ElectronicCats/flipper-addons/FLIPPER_CANBUS/CANBUS_Flipper.kicad_pcb

## KiCad design FLIPPER_CANBUS/CANBUS_Flipper.kicad_pcb (2025-12-16)

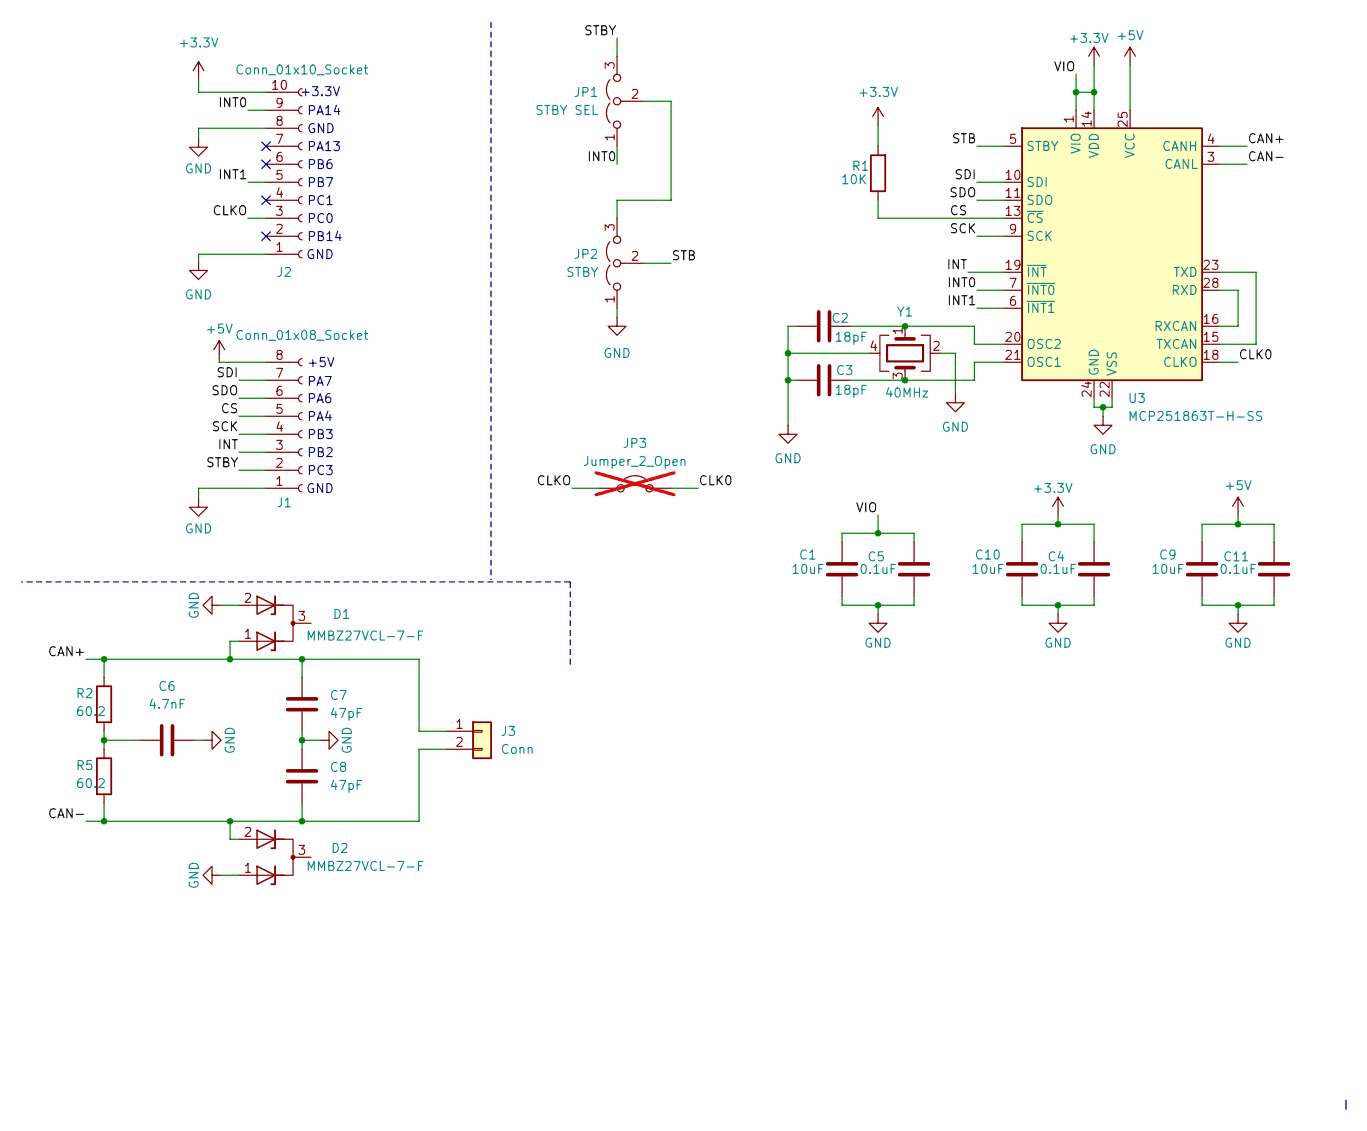
[picture p3: schematic CANBUS_Flipper.kicad_sch]

Parts:
C1, C9, C10: 10uF; C_0603_1608Metric; LCSC# C19702
C2, C3: 18pF; C_0603_1608Metric; LCSC# C5137620
C4, C5, C11: 0.1uF; C_0603_1608Metric; LCSC# C14663
C6: 4.7nF; C_0603_1608Metric; LCSC# C85980
C7, C8: 47pF; C_0603_1608Metric; LCSC# C5137501
D1, D2: MMBZ27VCL-7-F; SOT-23; LCSC# C698227
J1: Conn_01x08_Socket; PinHeader_1x08_P2.54mm_Vertical; LCSC# C7501586
J2: Conn_01x10_Socket; PinHeader_1x10_P2.54mm_Vertical; LCSC# C7430366
J3: Conn; TerminalBlock_bornier-2_P5.08mm
JP1: STBY SEL; Jumper; LCSC# C163836
JP2: STBY; Jumper; LCSC# C163836
JP3: Jumper_2_Open; SolderJumper-2_P1.3mm_Open_Pad1.0x1.5mm; not fitted
R1: 10K; R_0603_1608Metric; LCSC# C217281
R2, R5: 60.2; R_0603_1608Metric; LCSC# C2086358
U3: MCP251863T-H-SS; SSOP-28_5.3x10.2mm_P0.65mm; LCSC# C5226885
Y1: 40MHz; Crystal_SMD_EuroQuartz_MT-4Pin_3.2x2.5mm; LCSC# C1985459

Connections:
+3.3V: C1.2, C4.2, C5.2, C10.2, J2.10, R1.2, U3.1 (VIO), U3.14 (VDD)
+5V: C9.2, C11.2, J1.8, U3.25 (VCC)
/CAN+: C7.2, D1.1 (K), J3.1, R2.1, U3.4 (CANH)
/CAN-: C8.1, D2.2 (K), J3.2, R5.2, U3.3 (CANL)
/CLK0: JP3.2 (B), U3.18 (CLKO); also elsewhere on the board
/CLKO: J2.3; also elsewhere on the board
/CS: J1.5, R1.1, U3.13 (~CS)
/INT: J1.3, U3.19 (~INT)
/INT0: J2.9, JP1.1 (A), U3.7 (~INT0)
/INT1: J2.5, U3.6 (~INT1)
/SCK: J1.4, U3.9 (SCK)
/SDI: J1.7, U3.10 (SDI)
/SDO: J1.6, U3.11 (SDO)
/STB: JP2.2 (C), U3.5 (STBY)
/STBY: J1.2, JP1.3 (B)
GND: C1.1, C2.1, C3.1, C4.1, C5.1, C6.2, C7.1, C8.2, C9.1, C10.1, C11.1, D1.2 (K), D2.1 (K), J1.1, J2.1, J2.8, JP2.1 (A), U3.22 (VSS), U3.24 (GND), Y1.2, Y1.4
unnamed: C6.1, R2.2, R5.1
unnamed: JP1.2 (C), JP2.3 (B)
unnamed: C3.2, U3.21 (OSC1), Y1.3
unnamed: C2.2, U3.20 (OSC2), Y1.1
unnamed: U3.16 (RXCAN), U3.28 (RXD)
unnamed: U3.15 (TXCAN), U3.23 (TXD)

Notes on the sheet:
PA6
GND
PB3
PC1
PA7
+3.3V
PA13
PB6
PB14
PC3
PB2
PA14
+5V
PA4
PB7
PC0

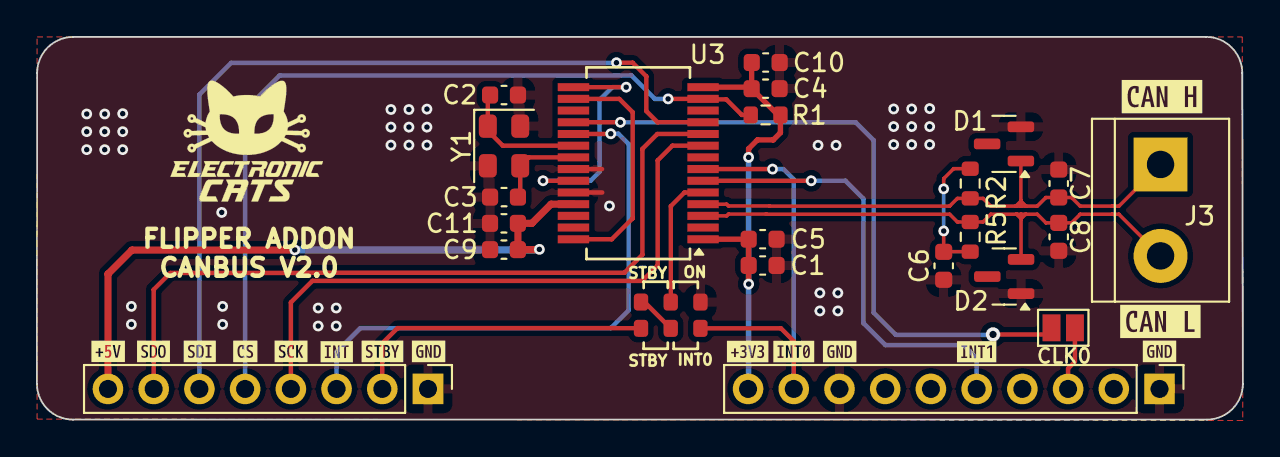
[picture p4: board CANBUS_Flipper.kicad_pcb from above]

Board: 2 copper layers, 67.0 x 21.3 mm, 39 parts (0 on the bottom side), 22 nets.

Other parts of the board:
CLK0: Jumper_2_Open; SolderJumper-2_P1.3mm_Open_Pad1.0x1.5mm
kibuzzard-65B92FFC: G***; kibuzzard-65B92FFC
kibuzzard-65B9300E: G***; kibuzzard-65B9300E
kibuzzard-6930B2A6: G***; kibuzzard-6930B2A6
kibuzzard-6930B2E0: G***; kibuzzard-6930B2E0
kibuzzard-6930B9E8: G***; kibuzzard-6930B9E8
kibuzzard-6930B93D: G***; kibuzzard-6930B93D
kibuzzard-6930B209: G***; kibuzzard-6930B209
kibuzzard-6930B295: G***; kibuzzard-6930B295
kibuzzard-6930B972: G***; kibuzzard-6930B972
kibuzzard-6930BA9C: G***; kibuzzard-6930BA9C
kibuzzard-6930BA32: G***; kibuzzard-6930BA32
kibuzzard-6930BA54: G***; kibuzzard-6930BA54
kibuzzard-6930BA73: G***; kibuzzard-6930BA73
kibuzzard-6930BAB6: G***; kibuzzard-6930BAB6
kibuzzard-6930BAD2: G***; kibuzzard-6930BAD2

Their connections:
/CLK0: CLK0.2 (B); also elsewhere on the board
/CLKO: CLK0.1 (A); also elsewhere on the board
