ElectronicCats/flipper-addons/FLIPPER_ETHERNET/FLIPPER_ETHERNET.kicad_pcb

## KiCad design FLIPPER_ETHERNET/FLIPPER_ETHERNET.kicad_pcb (2025-05-27)

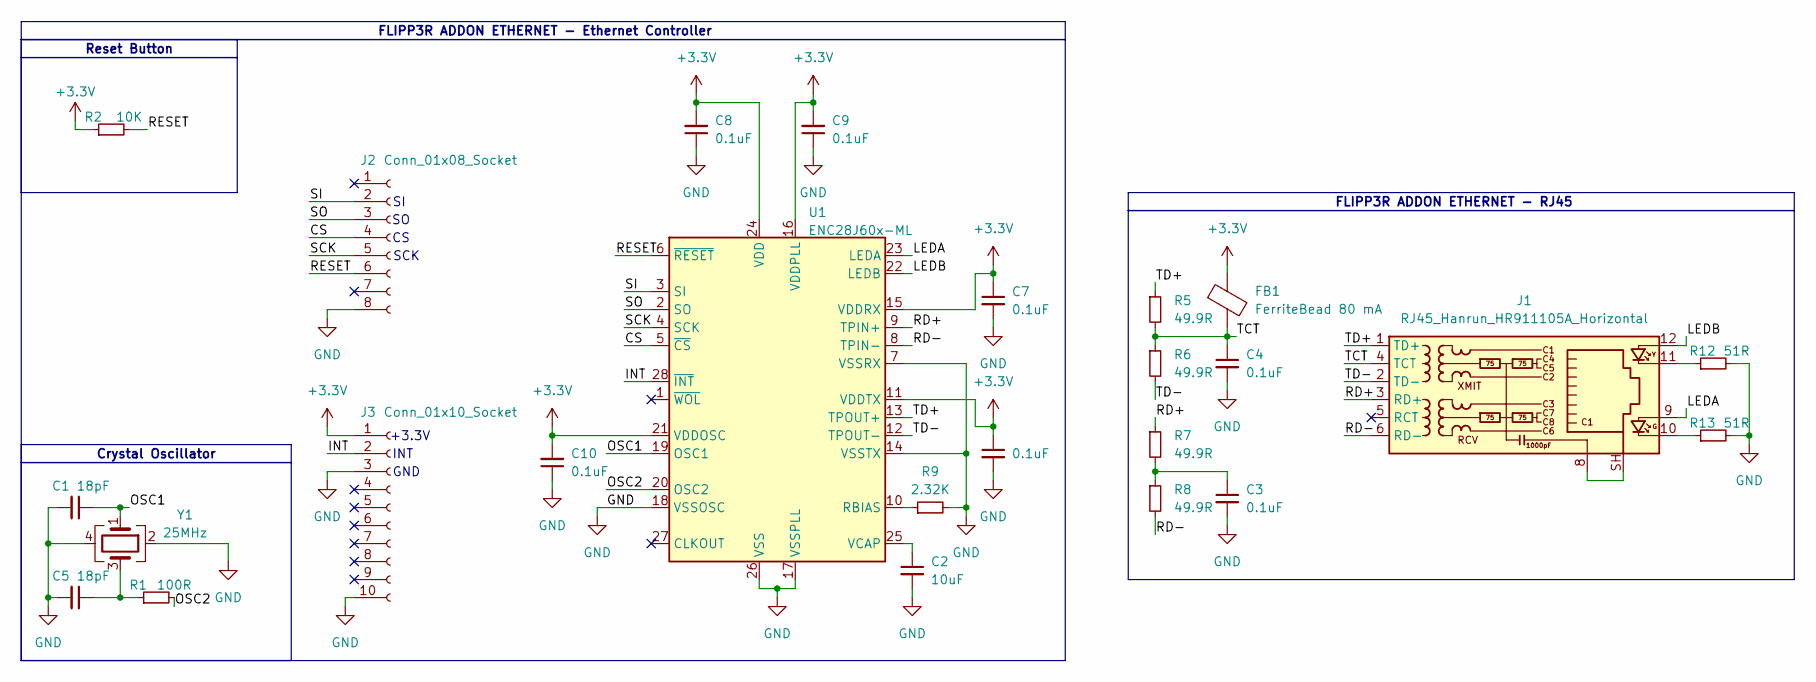
[picture p5: schematic FLIPPER_ETHERNET.kicad_sch, FLIPPER ADDON ETHERNET V1.0]

Parts:
C1, C5: 18pF; C_0603_1608Metric
C2: 10uF; C_0603_1608Metric
C3, C4, C6, C7, C8, C9, C10: 0.1uF; C_0603_1608Metric
FB1: FerriteBead 80 mA; BLM18SP221SN1B
J1: RJ45_Hanrun_HR911105A_Horizontal
J2: Conn_01x08_Socket; PinHeader_1x08_P2.54mm_Vertical
J3: Conn_01x10_Socket; PinHeader_1x10_P2.54mm_Vertical
R1: 100R; R_0603_1608Metric
R2: 10K; R_0603_1608Metric
R5, R6, R7, R8: 49.9R; R_0603_1608Metric
R9: 2.32K; R_0603_1608Metric
R12, R13: 51R; R_0603_1608Metric
U1: ENC28J60x-ML; QFN-28-1EP_6x6mm_P0.65mm_EP4.25x4.25mm
Y1: 25MHz; Crystal_SMD_SeikoEpson_FA128-4Pin_2.0x1.6mm

Connections:
+3.3V: C6.1, C7.1, C8.2, C9.2, C10.2, FB1.1, J3.1, R2.1, U1.11 (VDDTX), U1.15 (VDDRX), U1.16 (VDDPLL), U1.21 (VDDOSC), U1.24 (VDD)
/CS: J2.4, U1.5 (~CS)
/INT: J3.2, U1.28 (~INT)
/LEDA: J1.9, U1.23 (LEDA)
/LEDB: J1.12, U1.22 (LEDB)
/OSC1: C1.1, U1.19 (OSC1), Y1.1
/OSC2: R1.2, U1.20 (OSC2)
/RD+: J1.3 (RD+), R7.1, U1.9 (TPIN+)
/RD-: J1.6 (RD-), R8.2, U1.8 (TPIN-)
/RESET: J2.6, R2.2, U1.6 (~RESET)
/SCK: J2.5, U1.4 (SCK)
/SI: J2.2, U1.3 (SI)
/SO: J2.3, U1.2 (SO)
/TCT: C4.1, FB1.2, J1.4 (TCT), R5.2, R6.1
/TD+: J1.1 (TD+), R5.1, U1.13 (TPOUT+)
/TD-: J1.2 (TD-), R6.2, U1.12 (TPOUT-)
GND: C1.2, C2.2, C3.2, C4.2, C5.2, C6.2, C7.2, C8.1, C9.1, C10.1, J2.8, J3.3, J3.10, R9.2, R12.2, R13.2, U1.7 (VSSRX), U1.14 (VSSTX), U1.17 (VSSPLL), U1.18 (VSSOSC), U1.26 (VSS), Y1.2, Y1.4
unnamed: C3.1, R7.2, R8.1
unnamed: C5.1, R1.1, Y1.3
unnamed: J1.8, J1.SH
unnamed: J1.10, R13.1
unnamed: J1.11, R12.1
unnamed: R9.1, U1.10 (RBIAS)
unnamed: C2.1, U1.25 (VCAP)

Notes on the sheet:
FLIPP3R ADDON ETHERNET - Ethernet Controller
Crystal Oscillator
FLIPP3R ADDON ETHERNET - RJ45
INT
SCK
GND
+3.3V
Reset Button

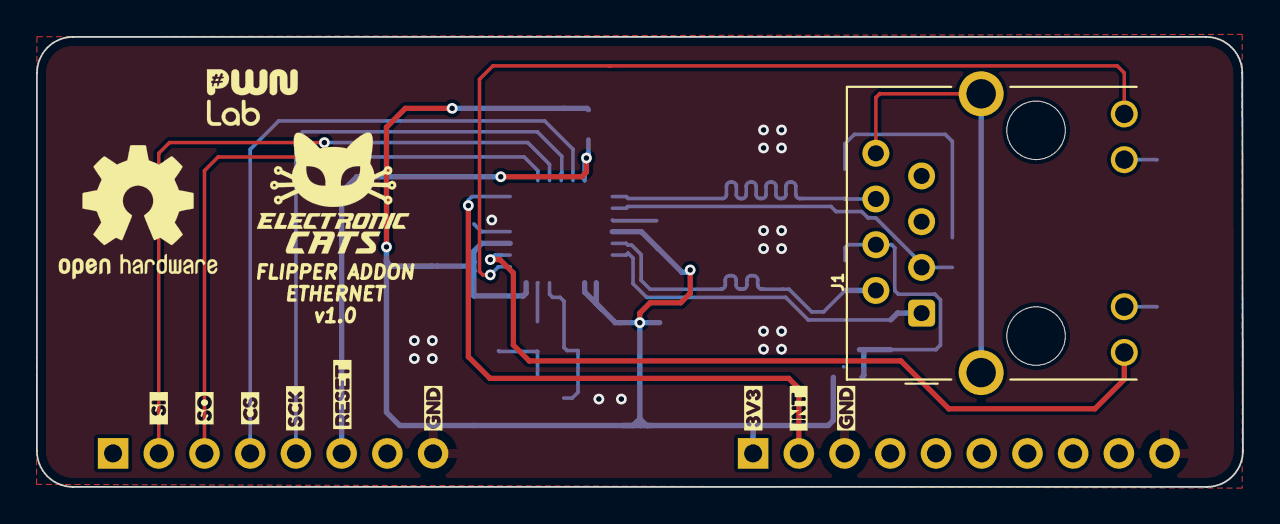
[picture p6: board FLIPPER_ETHERNET.kicad_pcb from above]

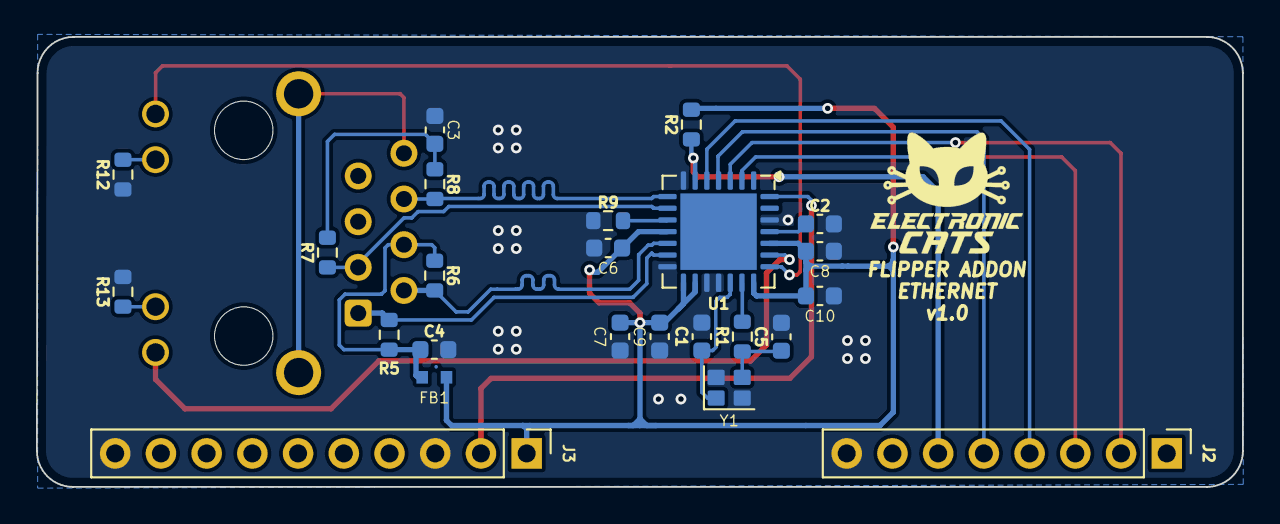
[picture p7: board FLIPPER_ETHERNET.kicad_pcb from below]

Board: 2 copper layers, 67.0 x 25.0 mm, 34 parts (24 on the bottom side), 24 nets.

Other parts of the board:
kibuzzard-6706FBB6, kibuzzard-6706FBB6#2: G***; kibuzzard-6706FBB6
kibuzzard-6706FC38: G***; kibuzzard-6706FC38
kibuzzard-6706FD0C: G***; kibuzzard-6706FD0C
kibuzzard-6706FE25: G***; kibuzzard-6706FE25
kibuzzard-6706FEBD: G***; kibuzzard-6706FEBD
kibuzzard-6706FECB: G***; kibuzzard-6706FECB
kibuzzard-6706FEE4: G***; kibuzzard-6706FEE4
kibuzzard-6835A348: G***; kibuzzard-6835A348
