ElectronicCats/flipper-addons/MARAUDER_SPOOF/marauder_spoof.kicad_pcb

## KiCad design MARAUDER_SPOOF/marauder_spoof.kicad_pcb (2025-04-08)

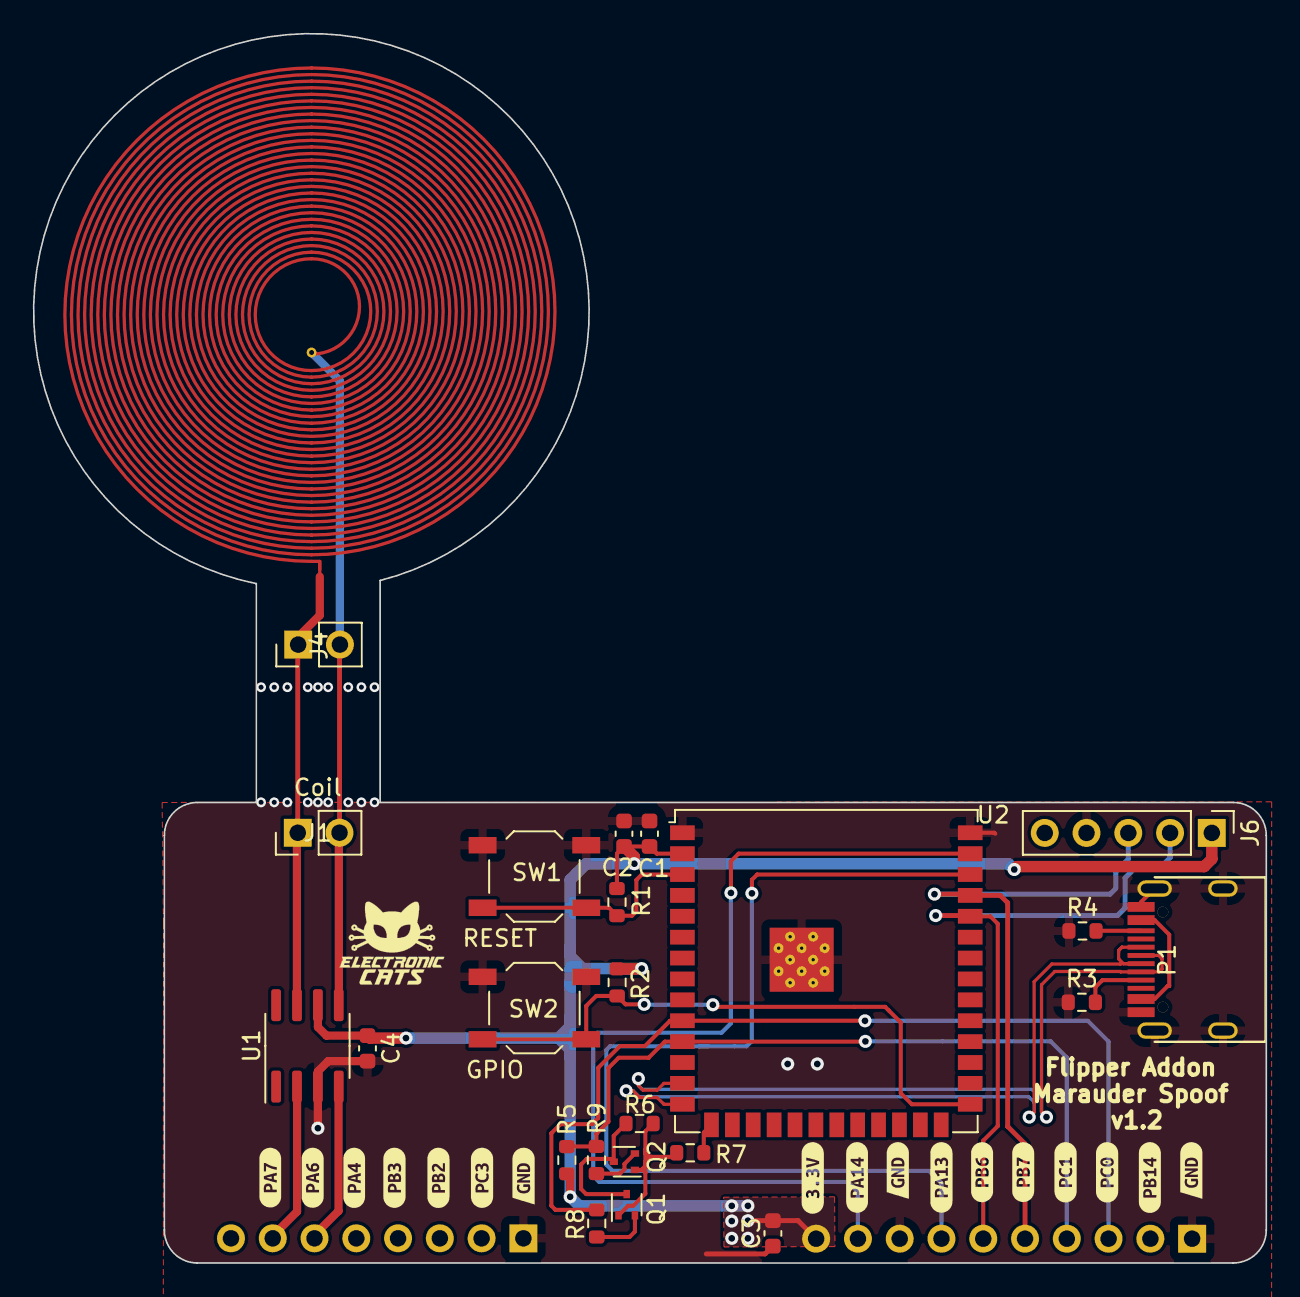
[picture p8: board marauder_spoof.kicad_pcb from above]

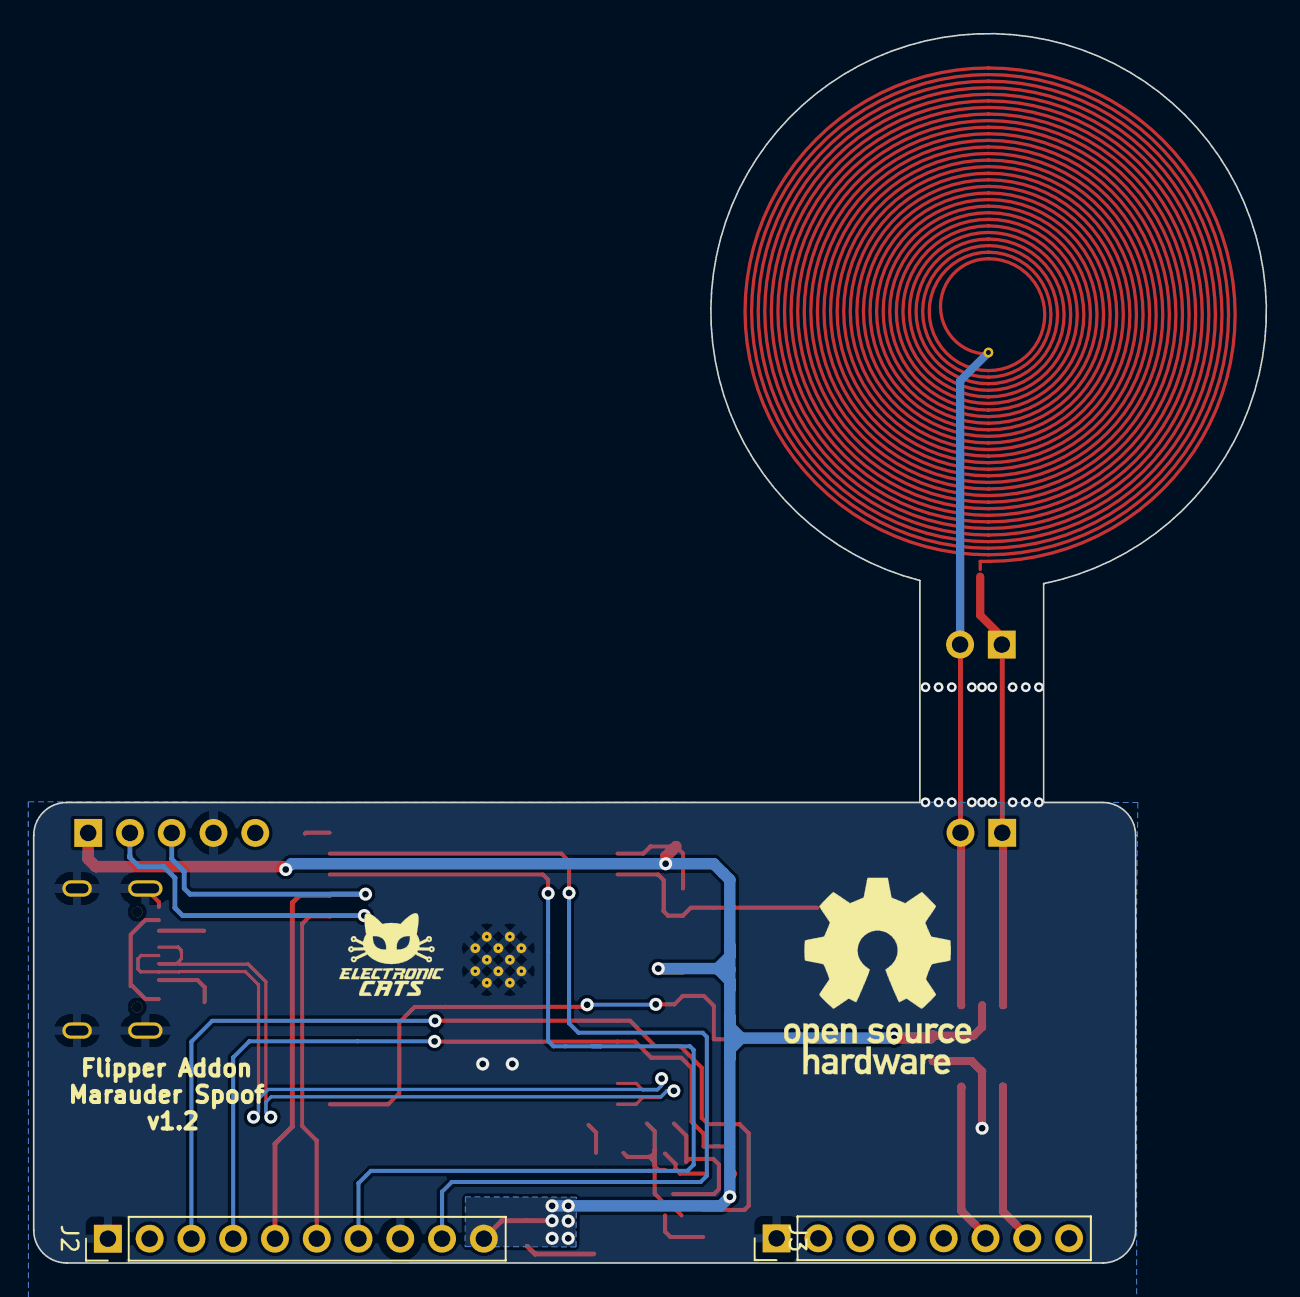
[picture p9: board marauder_spoof.kicad_pcb from below]

Board: 2 copper layers, 74.9 x 74.7 mm, 43 parts (2 on the bottom side), 23 nets.

Parts:
C1: 1uF; C_0603_1608Metric
C2, C3, C4: 10uF; C_0603_1608Metric
J1, J4: Coil; PinHeader_1x02_P2.54mm_Vertical
J2: Conn_01x10_Socket; PinHeader_1x10_P2.54mm_Vertical
J3: Conn_01x08_Socket; PinHeader_1x08_P2.54mm_Vertical
J6: GPS; PinHeader_1x05_P2.54mm_Vertical
L1: 30t_30mm; Coil_30t_30mm_0.2_0.2_0.6_0.3
P1: USB_C_Plug_USB2.0; C393939
Q1, Q2: DMP2004TK-7; SOT-523
R1, R2, R5, R6: 10K; R_0603_1608Metric
R3, R4: 5k1; R_0603_1608Metric
R7: 150; R_0603_1608Metric
R8, R9: 4k7; R_0603_1608Metric
SW1: RESET; SW_SPST_TL3342
SW2: GPIO; SW_SPST_TL3342
U1: TC4424; SOIC-8_3.9x4.9mm_P1.27mm
U2: ESP32-S3-WROOM-1U-N4; ESP32-S3-WROOM-1U
kibuzzard-648B91CB: G***; kibuzzard-648B91CB
kibuzzard-648B91E6: G***; kibuzzard-648B91E6
kibuzzard-648B91FC: G***; kibuzzard-648B91FC
kibuzzard-648B93B1: G***; kibuzzard-648B93B1
kibuzzard-648B93BF: G***; kibuzzard-648B93BF
kibuzzard-648B93D2: G***; kibuzzard-648B93D2
kibuzzard-648B93E0: G***; kibuzzard-648B93E0
kibuzzard-648B93EF: G***; kibuzzard-648B93EF
kibuzzard-648B921B: G***; kibuzzard-648B921B
kibuzzard-648B922F: G***; kibuzzard-648B922F
kibuzzard-648B923F: G***; kibuzzard-648B923F
kibuzzard-648B9401: G***; kibuzzard-648B9401
kibuzzard-648B9410: G***; kibuzzard-648B9410
kibuzzard-6488EEAF, kibuzzard-6488EEAF#2, kibuzzard-6488EEAF#3: G***; kibuzzard-6488EEAF
kibuzzard-6488F75A: G***; kibuzzard-6488F75A

Connections:
+3V3: C1.1, C2.1, C3.1, C4.1, J2.10 (Pin_1), J6.1, R1.2, R2.2, R5.1, U1.6 (VDD), U2.2 (3V3)
/BOOT: R2.1, SW2.2, U2.27 (IO0)
/D+: P1.A6 (D+), U2.14 (IO20)
/D-: P1.A7 (D-), U2.13 (IO19)
/I2C_PULLUP: R7.1, U2.15 (IO3)
/IN_A: J3.7 (Pin_2), U1.2 (IN_A)
/IN_B: J3.6 (Pin_3), U1.4 (IN_B)
/LPUART_RX: J2.3 (Pin_8), R8.2, U2.10 (IO17)
/LPUART_TX: J2.4 (Pin_7), R5.2, R9.2, U2.11 (IO18)
/Out_A: J1.1, J4.1, L1.1, U1.7 (OUT_A)
/Out_B: J1.2, J4.2, U1.5 (OUT_B)
/RST: R1.1, SW1.2, U2.3 (EN)
/RX: J2.5 (Pin_6), J6.3, U2.37 (TXD0)
/SWCLK: J2.9 (Pin_2), U2.39 (IO1)
/SWDIO: J2.7 (Pin_4), U2.38 (IO2)
/TX: J2.6 (Pin_5), J6.2, U2.36 (RXD0)
GND: C1.2, C2.2, C3.2, C4.2, J2.1 (Pin_10), J2.8 (Pin_3), J3.1 (Pin_8), J6.4, P1.A1 (GND), P1.S1 (SHIELD), R3.1, R4.1, SW1.1, SW2.1, U1.3 (GND), U2.1 (GND), U2.40 (GND), U2.41 (GND)
unnamed: P1.A5 (CC), R3.2
unnamed: P1.B5 (VCONN), R4.2
unnamed: Q1.3 (D), Q2.3 (D), R6.2
unnamed: Q1.1 (G), Q2.1 (G), R6.1, R7.2
unnamed: Q1.2 (S), R8.1
unnamed: Q2.2 (S), R9.1
