ElectronicCats/flipper-addons/FLIPPER_MOD_BUS/FLIPPER_MOD_BUS.kicad_pcb

## KiCad design FLIPPER_MOD_BUS/FLIPPER_MOD_BUS.kicad_pcb (2024-08-22)

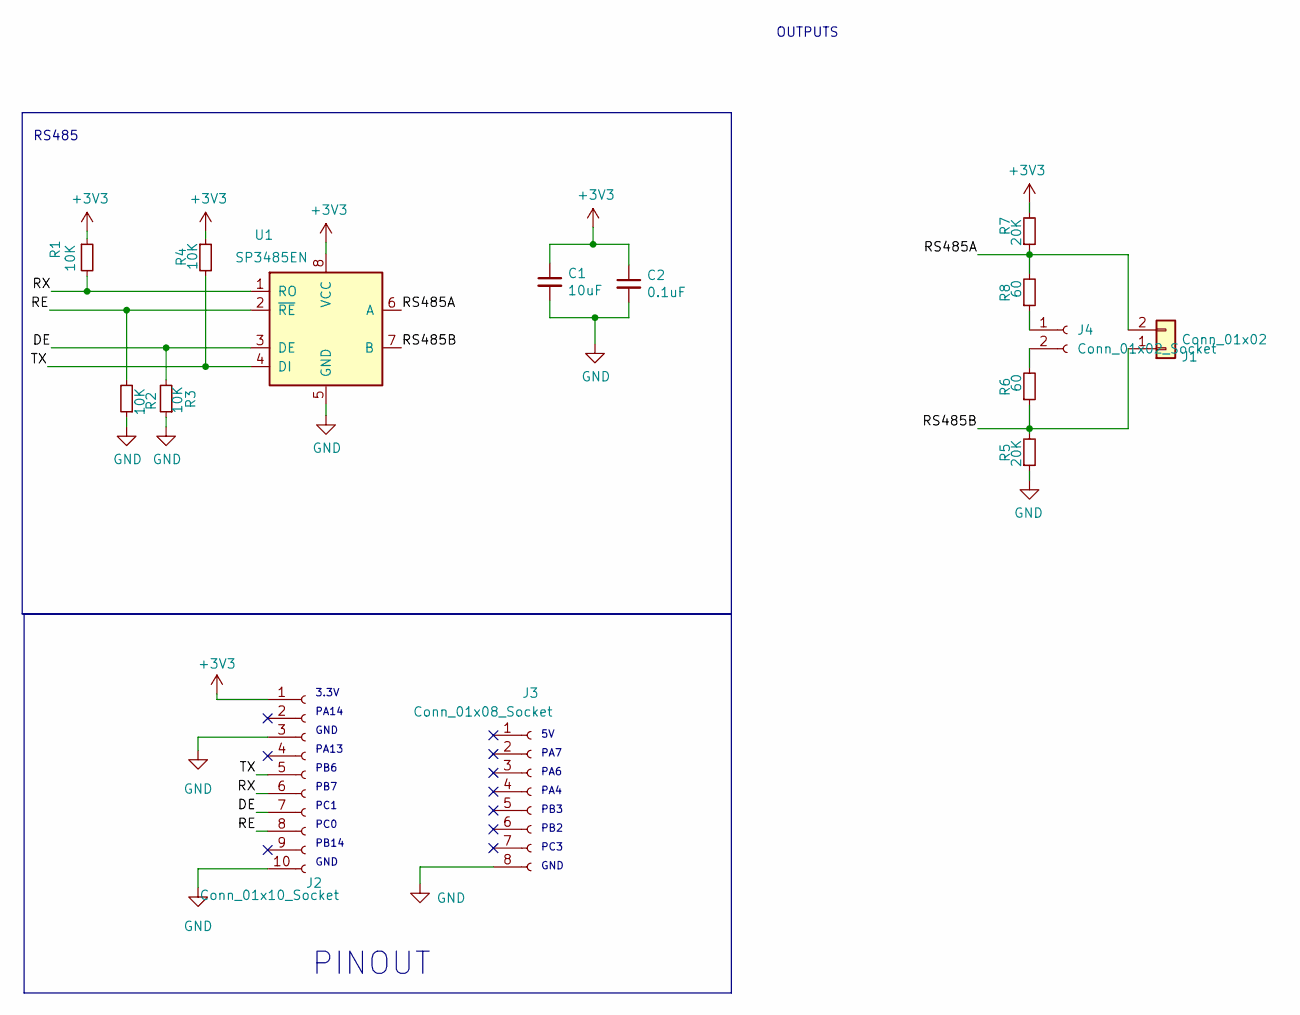
[picture p10: schematic FLIPPER_MOD_BUS.kicad_sch, Flippe ModBus]

Parts:
C1: 10uF; C_0603_1608Metric_Pad1.08x0.95mm_HandSolder; LCSC# C326057
C2: 0.1uF; C_0603_1608Metric_Pad1.08x0.95mm_HandSolder; LCSC# C14663
J1: Conn_01x02; TerminalBlock_bornier-2_P5.08mm
J2: Conn_01x10_Socket; PinHeader_1x10_P2.54mm_Vertical; LCSC# C492409
J3: Conn_01x08_Socket; PinHeader_1x08_P2.54mm_Vertical; LCSC# C492407
J4: Conn_01x02_Socket; PinHeader_1x02_P2.54mm_Vertical; LCSC# C7501580
R1, R2, R3, R4: 10K; R_0603_1608Metric_Pad0.98x0.95mm_HandSolder
R5, R7: 20K; R_0603_1608Metric_Pad0.98x0.95mm_HandSolder; LCSC# C25586
R6, R8: 60; R_1206_3216Metric_Pad1.30x1.75mm_HandSolder
U1: SP3485EN; SOIC-8_3.9x4.9mm_P1.27mm

Connections:
+3V3: C1.1, C2.1, J2.1, R1.1, R4.1, R7.2, U1.8 (VCC)
/DE: J2.7, R3.2, U1.3 (DE)
/RE: J2.8, R2.2, U1.2 (~RE)
/RS485A: J1.2, R7.1, R8.2, U1.6 (A)
/RS485B: J1.1, R5.2, R6.1, U1.7 (B)
/RX: J2.6, R1.2, U1.1 (RO)
/TX: J2.5, R4.2, U1.4 (DI)
GND: C1.2, C2.2, J2.3, J2.10, J3.8, R2.1, R3.1, R5.1, U1.5 (GND)
unnamed: J4.1, R8.1
unnamed: J4.2, R6.2

Notes on the sheet:
GND
PA4
PINOUT
PC3
PC1
PA6
PB3
PB7
OUTPUTS
PA14
3.3V
PC0
PA7
PB2
PB6
PA13
PB14
RS485

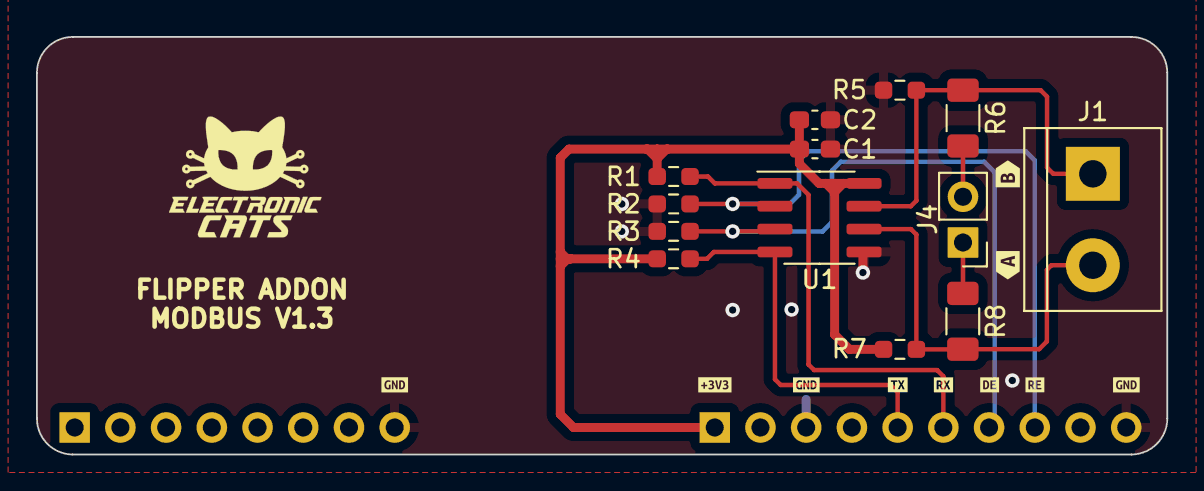
[picture p11: board FLIPPER_MOD_BUS.kicad_pcb from above]

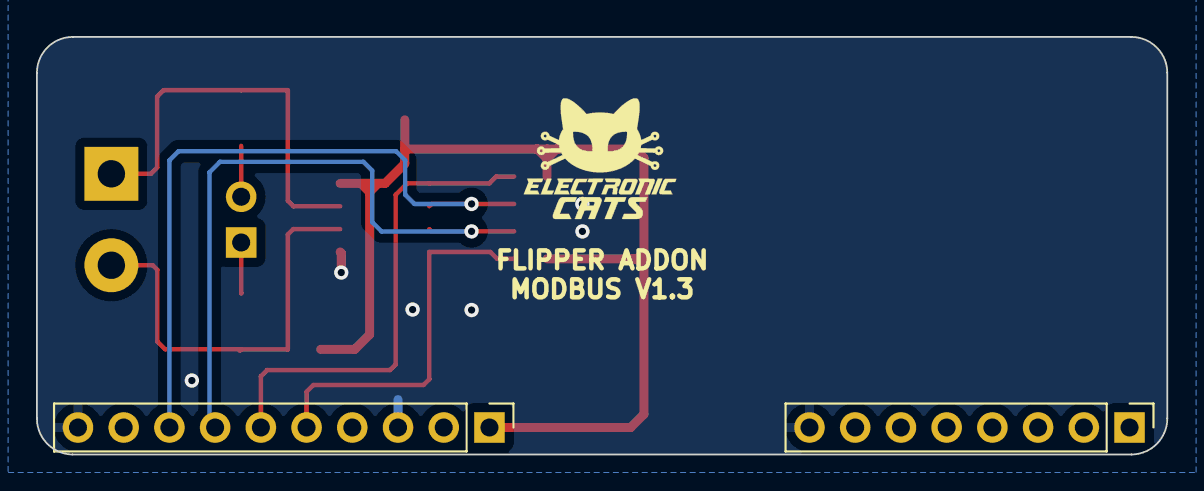
[picture p12: board FLIPPER_MOD_BUS.kicad_pcb from below]

Board: 2 copper layers, 62.8 x 23.2 mm, 25 parts (2 on the bottom side), 10 nets.

Other parts of the board:
kibuzzard-65A7F6B7: G***; kibuzzard-65A7F6B7
kibuzzard-65A7F6E6: G***; kibuzzard-65A7F6E6
kibuzzard-65A7F6FE: G***; kibuzzard-65A7F6FE
kibuzzard-65A7F66D, kibuzzard-65A7F66D#2: G***; kibuzzard-65A7F66D
kibuzzard-65A7F651: G***; kibuzzard-65A7F651
kibuzzard-65A7F695: G***; kibuzzard-65A7F695
kibuzzard-65B028C6: G***; kibuzzard-65B028C6
kibuzzard-65B028F3: G***; kibuzzard-65B028F3
kibuzzard-644AD5FD: G***; kibuzzard-644AD5FD
