ElectronicCats/flipper-addons/FLIPPER_UWB/Flipper_UWB.kicad_pcb

## KiCad design FLIPPER_UWB/Flipper_UWB.kicad_pcb (2024-08-22)

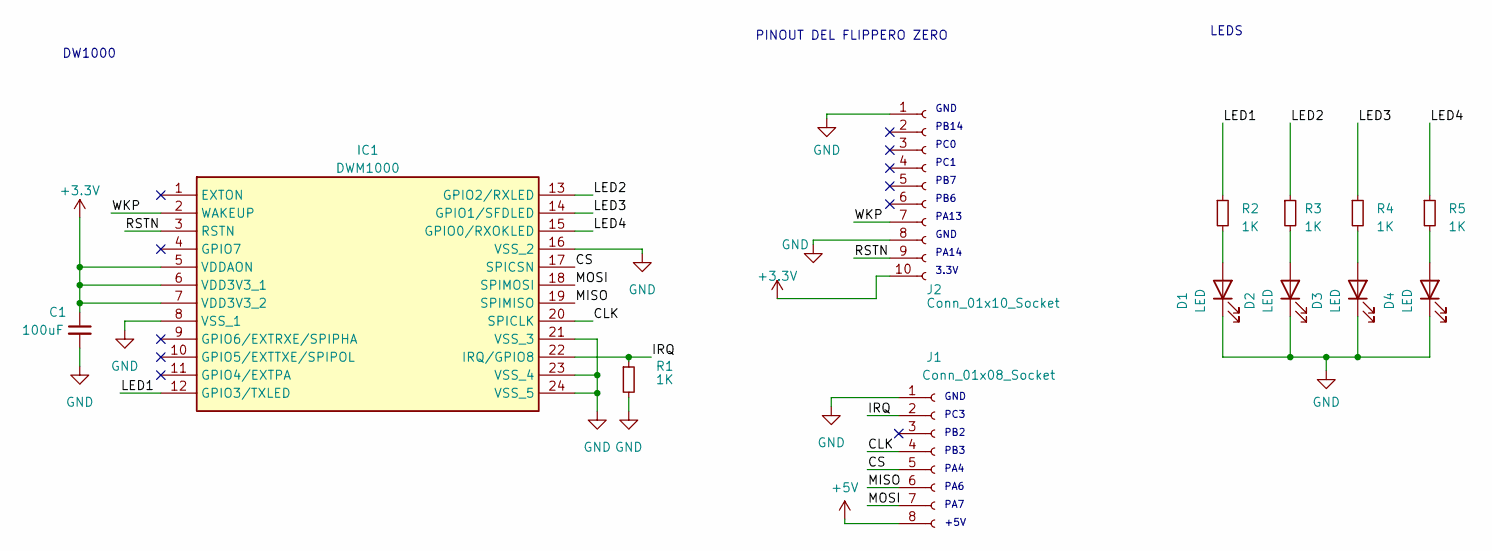
[picture p13: schematic Flipper_UWB.kicad_sch]

Parts:
C1: 100uF; C_0805_2012Metric
D1, D2: LED; LED_0805_2012Metric; LCSC# C205442
D3: LED; LED_0805_2012Metric; LCSC# C84261
D4: LED; LED_0805_2012Metric; LCSC# C130114
IC1: DWM1000
J1: Conn_01x08_Socket; PinHeader_1x08_P2.54mm_Horizontal
J2: Conn_01x10_Socket; PinHeader_1x10_P2.54mm_Horizontal
R1, R2, R3, R4, R5: 1K; R_0805_2012Metric; LCSC# C25623

Connections:
+3.3V: C1.1, IC1.5 (VDDAON), IC1.6 (VDD3V3_1), IC1.7 (VDD3V3_2), J2.10
+5V: J1.8
/CLK: IC1.20 (SPICLK), J1.4
/CS: IC1.17 (SPICSN), J1.5
/IRQ: IC1.22 (IRQ/GPIO8), J1.2, R1.1
/LED1: IC1.12 (GPIO3/TXLED), R2.1
/LED2: IC1.13 (GPIO2/RXLED), R3.1
/LED3: IC1.14 (GPIO1/SFDLED), R4.1
/LED4: IC1.15 (GPIO0/RXOKLED), R5.1
/MISO: IC1.19 (SPIMISO), J1.6
/MOSI: IC1.18 (SPIMOSI), J1.7
/RSTN: IC1.3 (RSTN), J2.9
/WKP: IC1.2 (WAKEUP), J2.7
GND: C1.2, D1.1 (K), D2.1 (K), D3.1 (K), D4.1 (K), IC1.8 (VSS_1), IC1.16 (VSS_2), IC1.21 (VSS_3), IC1.23 (VSS_4), IC1.24 (VSS_5), J1.1, J2.1, J2.8, R1.2
unnamed: D1.2 (A), R2.2
unnamed: D2.2 (A), R3.2
unnamed: D3.2 (A), R4.2
unnamed: D4.2 (A), R5.2

Notes on the sheet:
PA13
PC1
DW1000
GND
PB2
PA14
PA7
PA4
+5V
PB14
PINOUT DEL FLIPPERO ZERO
PA6
PB6
PC3
LEDS
3.3V
PB7
PC0
PB3

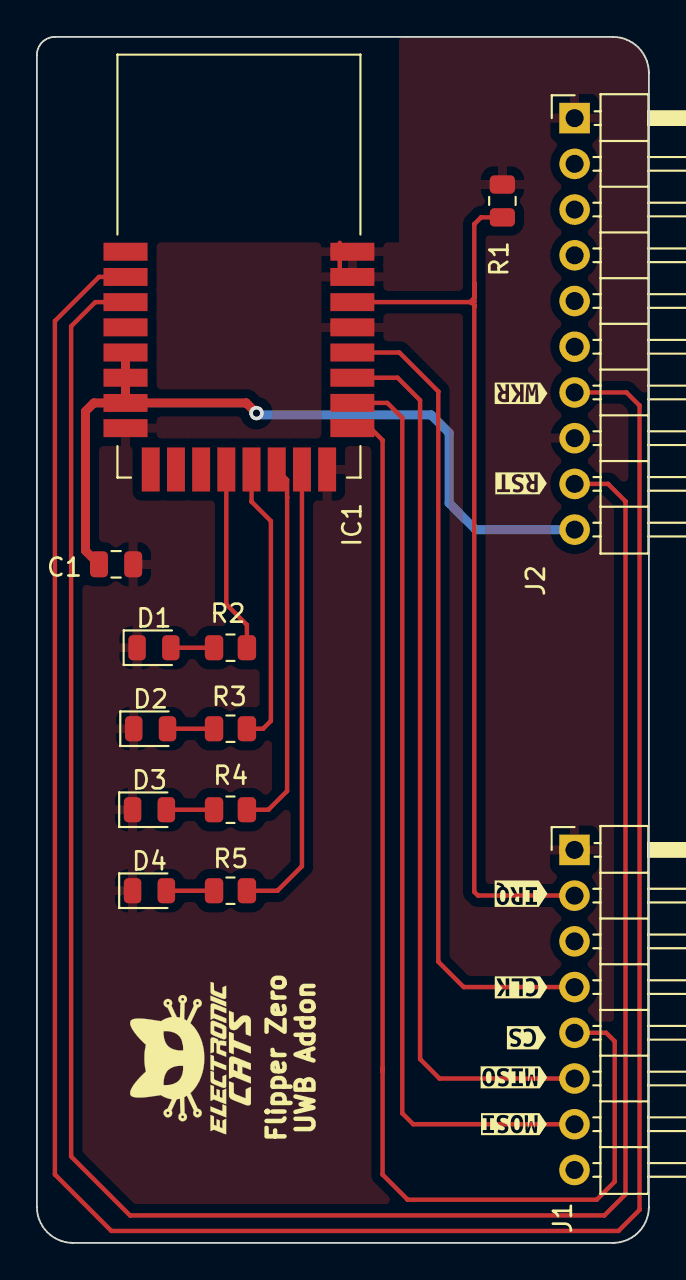
[picture p14: board Flipper_UWB.kicad_pcb from above]

Board: 2 copper layers, 34.0 x 67.0 mm, 20 parts (0 on the bottom side), 17 nets.

Other parts of the board:
kibuzzard-644AA5E2: G***; kibuzzard-644AA5E2
kibuzzard-644AA5EC: G***; kibuzzard-644AA5EC
kibuzzard-644AA5FA: G***; kibuzzard-644AA5FA
kibuzzard-644AA62C: G***; kibuzzard-644AA62C
kibuzzard-644AA606: G***; kibuzzard-644AA606
kibuzzard-644AA610: G***; kibuzzard-644AA610
kibuzzard-644AA622: G***; kibuzzard-644AA622
