ElectronicCats/flipper-addons/FLIPPER_MAGSPOOF/mags.kicad_pcb

## KiCad design FLIPPER_MAGSPOOF/mags.kicad_pcb (2024-08-22)

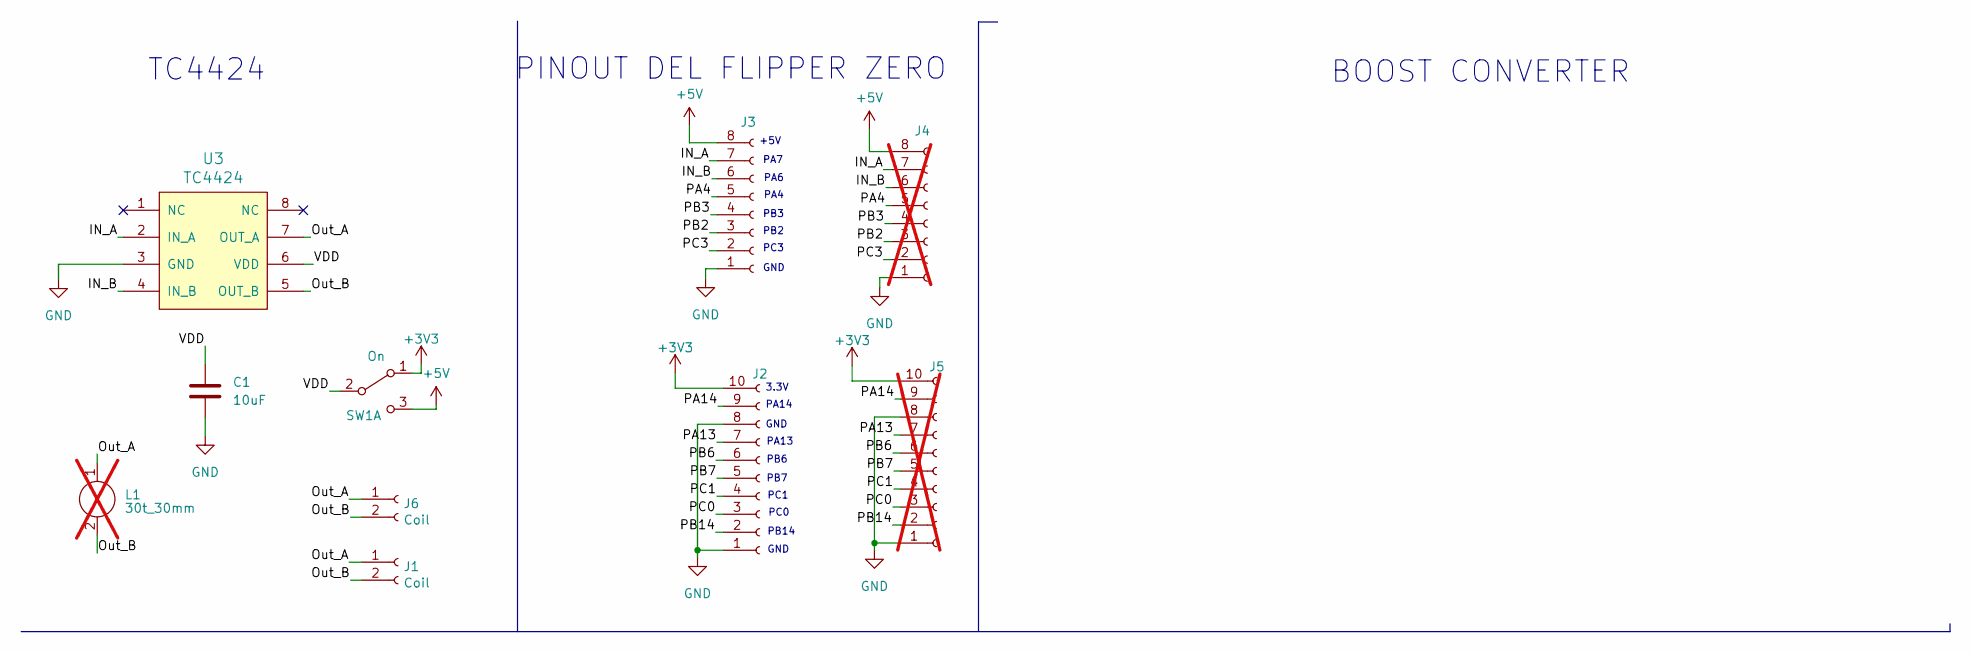
[picture p15: schematic mags.kicad_sch]

Parts:
C1: 10uF; C_0603_1608Metric; LCSC# C380314
J1, J6: Coil; PinHeader_1x02_P2.54mm_Vertical
J2: Conn_01x10_Socket; PinHeader_1x10_P2.54mm_Horizontal; LCSC# C57369
J3: Conn_01x08_Socket; PinHeader_1x08_P2.54mm_Horizontal; LCSC# C492407
J4: Conn_01x08_Socket; PinHeader_1x08_P2.54mm_Vertical; LCSC# C492407; not fitted
J5: Conn_01x10_Socket; PinHeader_1x10_P2.54mm_Vertical; LCSC# C57369; not fitted
L1: 30t_30mm; Coil_30t_30mm_0.2_0.2_0.6_0.3; not fitted
SW1: On; JS102011SAQN; LCSC# C221660
U3: TC4424; SOIC-8_3.9x4.9mm_P1.27mm; LCSC# C44150

Connections:
+3V3: J2.10 (Pin_1), J5.10 (Pin_1), SW1.1 (A)
+5V: J3.8 (Pin_1), J4.8 (Pin_1), SW1.3 (C)
/IN_A: J3.7 (Pin_2), J4.7 (Pin_2); also elsewhere on the board
/IN_B: J3.6 (Pin_3), J4.6 (Pin_3); also elsewhere on the board
/Out_A: J1.1, J6.1, L1.1; also elsewhere on the board
/Out_B: J1.2, J6.2, L1.2; also elsewhere on the board
/PA4: J3.5 (Pin_4), J4.5 (Pin_4)
/PA13: J2.7 (Pin_4), J5.7 (Pin_4)
/PA14: J2.9 (Pin_2), J5.9 (Pin_2)
/PB2: J3.3 (Pin_6), J4.3 (Pin_6)
/PB3: J3.4 (Pin_5), J4.4 (Pin_5)
/PB6: J2.6 (Pin_5), J5.6 (Pin_5)
/PB7: J2.5 (Pin_6), J5.5 (Pin_6)
/PB14: J2.2 (Pin_9), J5.2 (Pin_9)
/PC0: J2.3 (Pin_8), J5.3 (Pin_8)
/PC1: J2.4 (Pin_7), J5.4 (Pin_7)
/PC3: J3.2 (Pin_7), J4.2 (Pin_7)
/VDD: C1.1, SW1.2 (B); also elsewhere on the board
GND: C1.2, J2.1 (Pin_10), J2.8 (Pin_3), J3.1 (Pin_8), J4.1 (Pin_8), J5.1 (Pin_10), J5.8 (Pin_3); also elsewhere on the board

Notes on the sheet:
PC3
3.3V
PB3
PC1
PB2
PB7
PA4
GND
PB6
PA6
+5V
BOOST CONVERTER
PA7
PINOUT DEL FLIPPER ZERO
TC4424
PA14
PA13
PB14
PC0

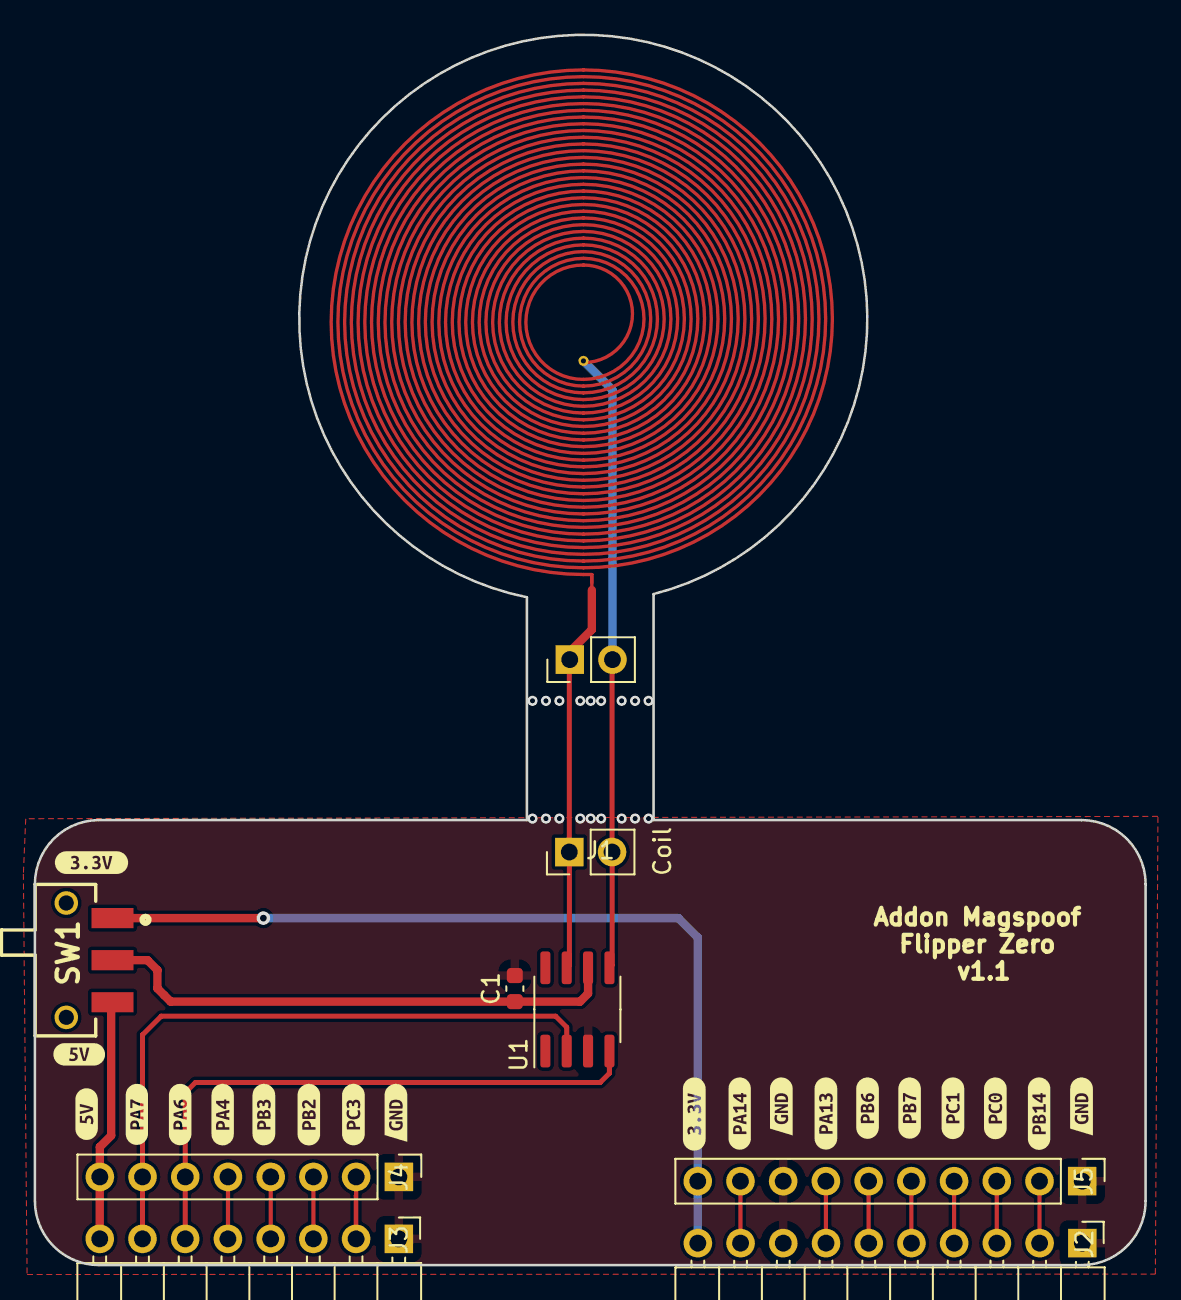
[picture p16: board mags.kicad_pcb from above]

Board: 2 copper layers, 66.0 x 73.1 mm, 30 parts (0 on the bottom side), 19 nets.

Other parts of the board:
U1: TC4424; SOIC-8_3.9x4.9mm_P1.27mm
kibuzzard-648B91CB: G***; kibuzzard-648B91CB
kibuzzard-648B91E6: G***; kibuzzard-648B91E6
kibuzzard-648B91FC: G***; kibuzzard-648B91FC
kibuzzard-648B93B1: G***; kibuzzard-648B93B1
kibuzzard-648B93BF: G***; kibuzzard-648B93BF
kibuzzard-648B93D2: G***; kibuzzard-648B93D2
kibuzzard-648B93E0: G***; kibuzzard-648B93E0
kibuzzard-648B93EF: G***; kibuzzard-648B93EF
kibuzzard-648B921B: G***; kibuzzard-648B921B
kibuzzard-648B922F: G***; kibuzzard-648B922F
kibuzzard-648B923F: G***; kibuzzard-648B923F
kibuzzard-648B9401: G***; kibuzzard-648B9401
kibuzzard-648B9410: G***; kibuzzard-648B9410
kibuzzard-649DB344, kibuzzard-649DB344#2: G***; kibuzzard-649DB344
kibuzzard-6488EEAF, kibuzzard-6488EEAF#2, kibuzzard-6488EEAF#3: G***; kibuzzard-6488EEAF
kibuzzard-6488F75A, kibuzzard-6488F75A#2: G***; kibuzzard-6488F75A

Their connections:
/IN_A: U1.2 (IN_A); also elsewhere on the board
/IN_B: U1.4 (IN_B); also elsewhere on the board
/Out_A: U1.7 (OUT_A); also elsewhere on the board
/Out_B: U1.5 (OUT_B); also elsewhere on the board
/VDD: U1.6 (VDD); also elsewhere on the board
GND: U1.3 (GND); also elsewhere on the board
