ElectronicCats/flipper-addons/FLIPPER_CANBUS/OBDII_connector/OBDII_connector.kicad_pcb

## KiCad design FLIPPER_CANBUS/OBDII_connector/OBDII_connector.kicad_pcb (2024-07-31)

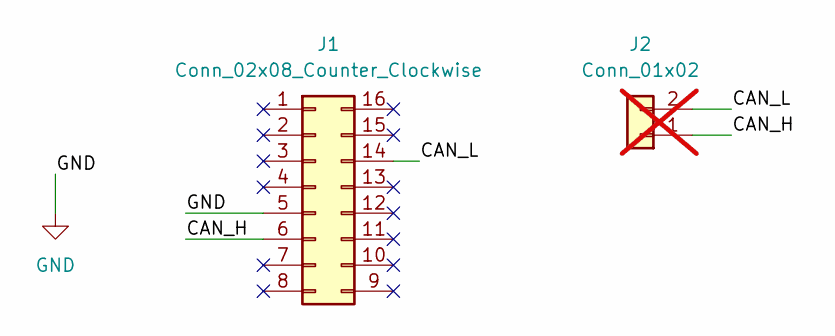
[picture p20: schematic OBDII_connector.kicad_sch]

Parts:
J1: Conn_02x08_Counter_Clockwise; OBD-II-Sparkfun v2.0
J2: Conn_01x02; PinHeader_1x02_P2.54mm_Vertical; not fitted

Connections:
/CAN_H: J1.6, J2.1
/CAN_L: J1.14, J2.2
GND: J1.5

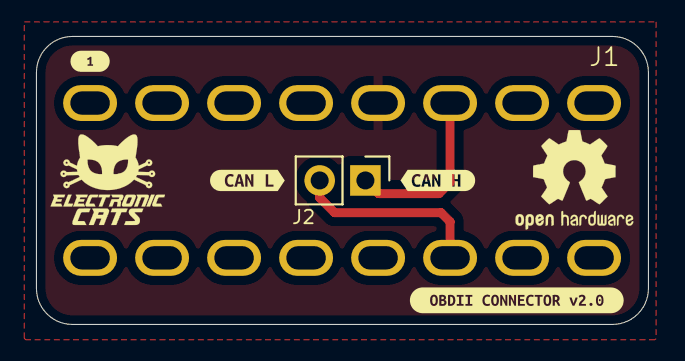
[picture p21: board OBDII_connector.kicad_pcb from above]

Board: 2 copper layers, 34.0 x 16.0 mm, 6 parts (0 on the bottom side), 2 nets.

Other parts of the board:
kibuzzard-66AA65D6: G***; kibuzzard-66AA65D6
kibuzzard-66AA65F0: G***; kibuzzard-66AA65F0
kibuzzard-6646749E: G***; kibuzzard-6646749E
kibuzzard-66467618: G***; kibuzzard-66467618
